fryza97/capacitance_meter/README.md

# capacitance_meter
A laboratory circuit for C measurements based on a direct sensor-to-microcontroller interface circuit and a PIC16F1789 microcontroller.
Engineering thesis from 2020.
