fryza97/capacitance_meter/hardware/fryza-miedź.brd

## EAGLE design hardware/fryza-miedź.brd (2024-04-22)

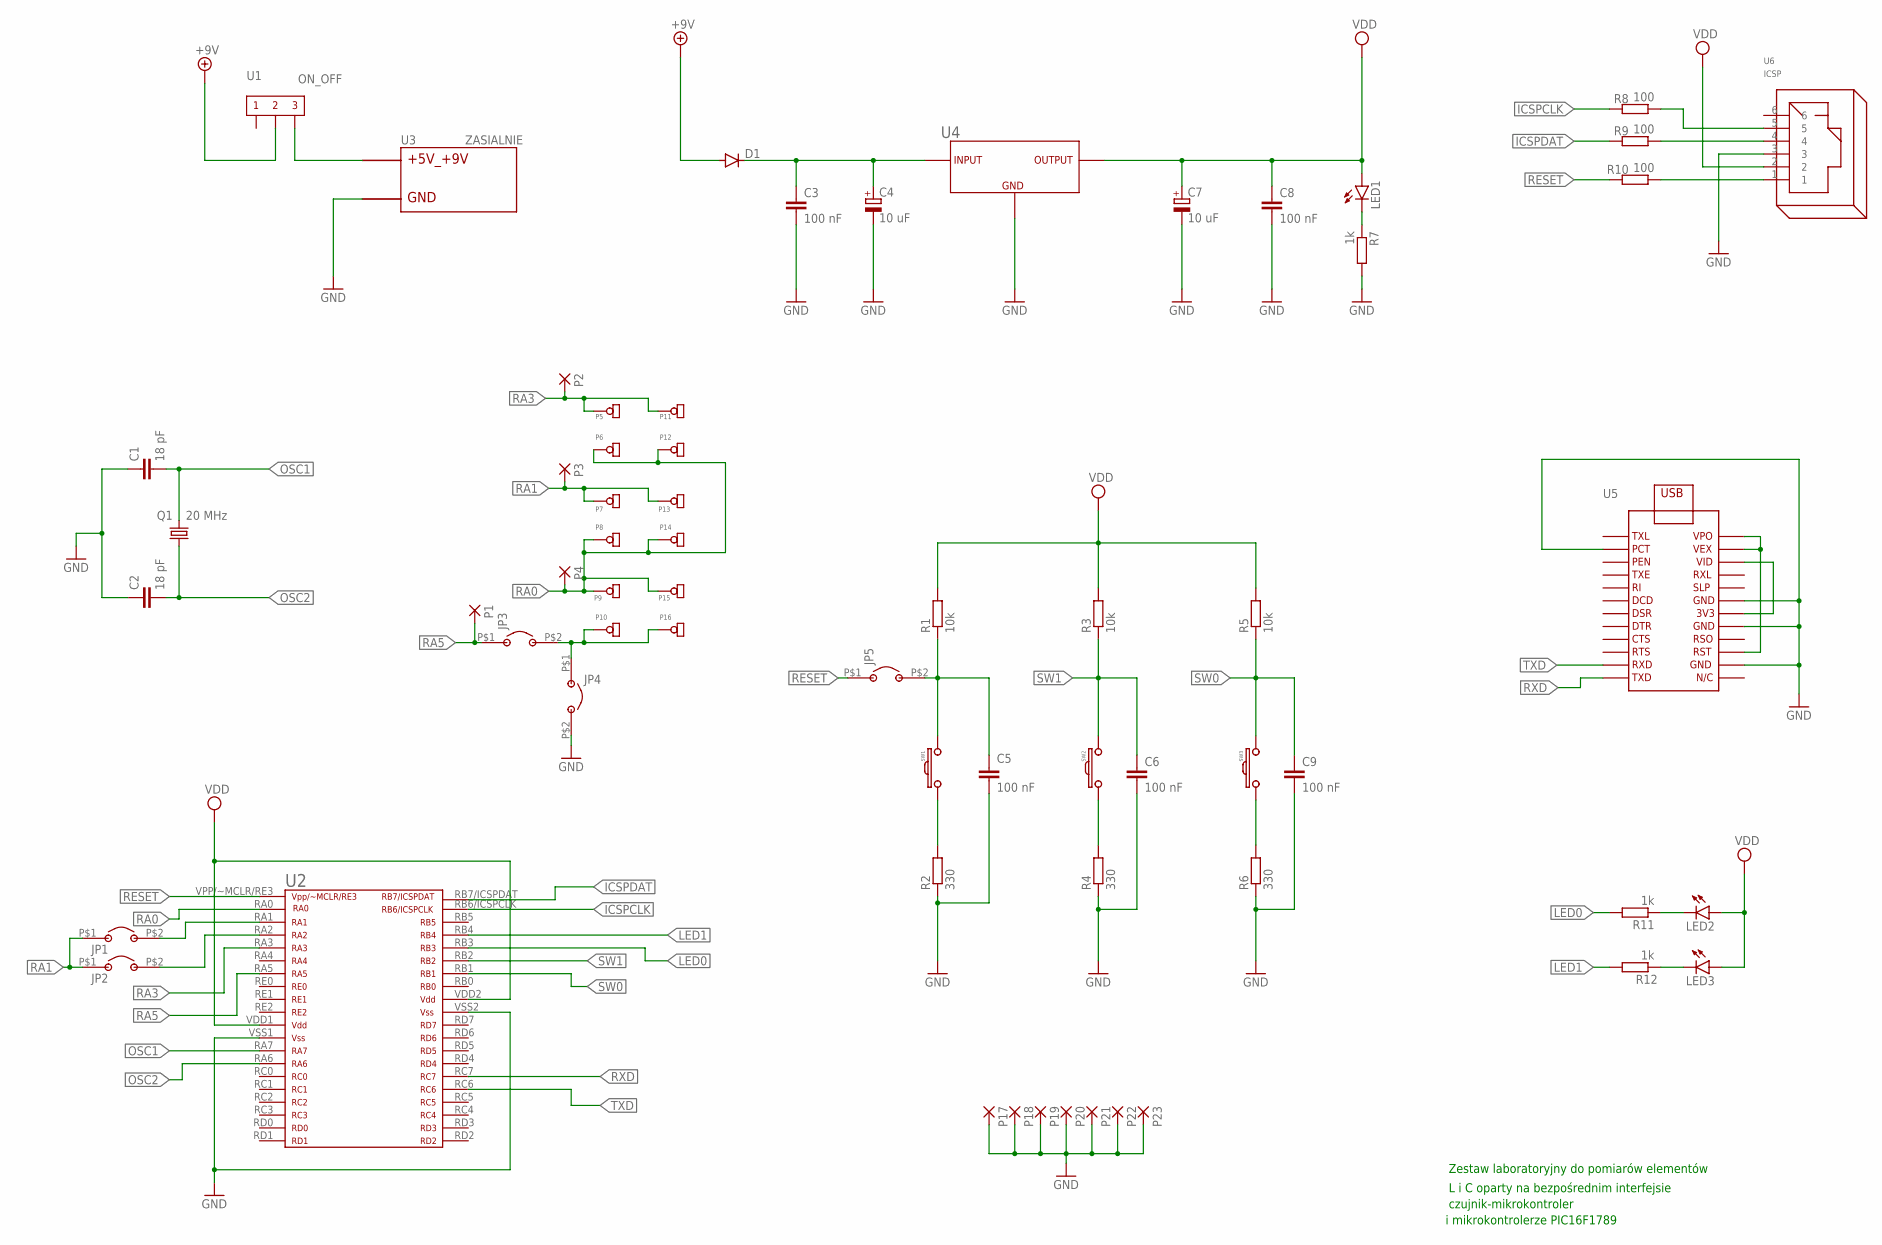
[picture p52: schematic fryza-miedź.sch]

Parts:
C1, C2: 18 pF; C050-035X075
C3, C5, C6, C8, C9: 100 nF; C050-035X075
C4, C7: 10 uF; E2,5-5
D1: 1N4004; DO41-10
JP1, JP2, JP3, JP4, JP5: JUMPER
LED1, LED2, LED3: LED5MM
P1, P2, P3, P4, P17, P18, P19, P20, P21, P22, P23: SZPILKA; CON
P5, P6, P7, P8, P9, P10, P11, P12, P13, P14, P15, P16: CON
Q1: 20 MHz; KWARC
R1, R3, R5: 10k; 0207/10
R2, R4, R6: 330; 0207/10
R7, R11, R12: 1k; 0207/10
R8, R9, R10: 100; 0207/10
SW1, SW2, SW3: PUSH_SWITCH
U1: ON_OFF; WLACZNIK
U2: PIC16F1789
U3: ZASIALNIE; ZASILANIE_ZLACZE
U4: LF33CV
U5: MMUSB232
U6: ICSP; RJ12

Connections:
+9V: D1.A, U1.2
GND: C1.1, C2.1, C3.2, C4.-, C5.2, C6.2, C7.-, C8.2, C9.2, JP4.P$2, P17.P$1, P18.P$1, P19.P$1, P20.P$1, P21.P$1, P22.P$1, P23.P$1, R2.1, R4.1, R6.1, R7.2, U2.VSS1, U2.VSS2, U3.GND1 (GND), U3.GND2 (GND), U4.GND, U5.GND, U5.GND1, U5.GND2, U5.PCT, U6.3
ICSPCLK: R8.2, U2.RB6/ICSPCLK
ICSPDAT: R9.2, U2.RB7/ICSPDAT
LED0: R11.2, U2.RB3
LED1: R12.2, U2.RB4
unnamed: C3.1, C4.+, D1.C, U4.INPUT
unnamed: LED1.K (C), R7.1
unnamed: U1.3, U3.V_S (+5V_+9V)
unnamed: C5.1, JP5.P$2, R1.1, SW1.1_1, SW1.1_2
unnamed: U5.RST, U5.VEX, U5.VPO
unnamed: JP3.P$2, JP4.P$1, P10.P$1, P16.P$1
unnamed: LED2.K (C), R11.1
unnamed: JP1.P$2, U2.RA1
unnamed: LED3.K (C), R12.1
unnamed: R10.1, U6.1
unnamed: R2.2, SW1.2_1, SW1.2_2
unnamed: R6.2, SW3.2_1, SW3.2_2
unnamed: R4.2, SW2.2_1, SW2.2_2
unnamed: U5.3V3, U5.VIO (VID)
unnamed: R8.1, U6.5
unnamed: R9.1, U6.4
OSC1: C1.2, Q1.P$2 (2), U2.RA7
OSC2: C2.2, Q1.P$1 (1), U2.RA6
RA0: P4.P$1, P6.P$1, P8.P$1, P9.P$1, P12.P$1, P14.P$1, P15.P$1, U2.RA0
RA1: JP1.P$1, JP2.P$1, P3.P$1, P7.P$1, P13.P$1
RA2: JP2.P$2, U2.RA2
RA3: P2.P$1, P5.P$1, P11.P$1, U2.RA3
RA5: JP3.P$1, P1.P$1, U2.RA5
RESET: JP5.P$1, R10.2, U2.VPP/~MCLR/RE3
RXD: U2.RC7, U5.TXD
SW0: C9.1, R5.1, SW3.1_1, SW3.1_2, U2.RB1
SW1: C6.1, R3.1, SW2.1_1, SW2.1_2, U2.RB2
TXD: U2.RC6, U5.RXD
VDD: C7.+, C8.1, LED1.A, LED2.A, LED3.A, R1.2, R3.2, R5.2, U2.VDD1, U2.VDD2, U4.OUTPUT, U6.2

Notes on the sheet:
Zestaw laboratoryjny do pomiarów elementów
L i C oparty na bezpośrednim interfejsie
czujnik-mikrokontroler
i mikrokontrolerze PIC16F1789

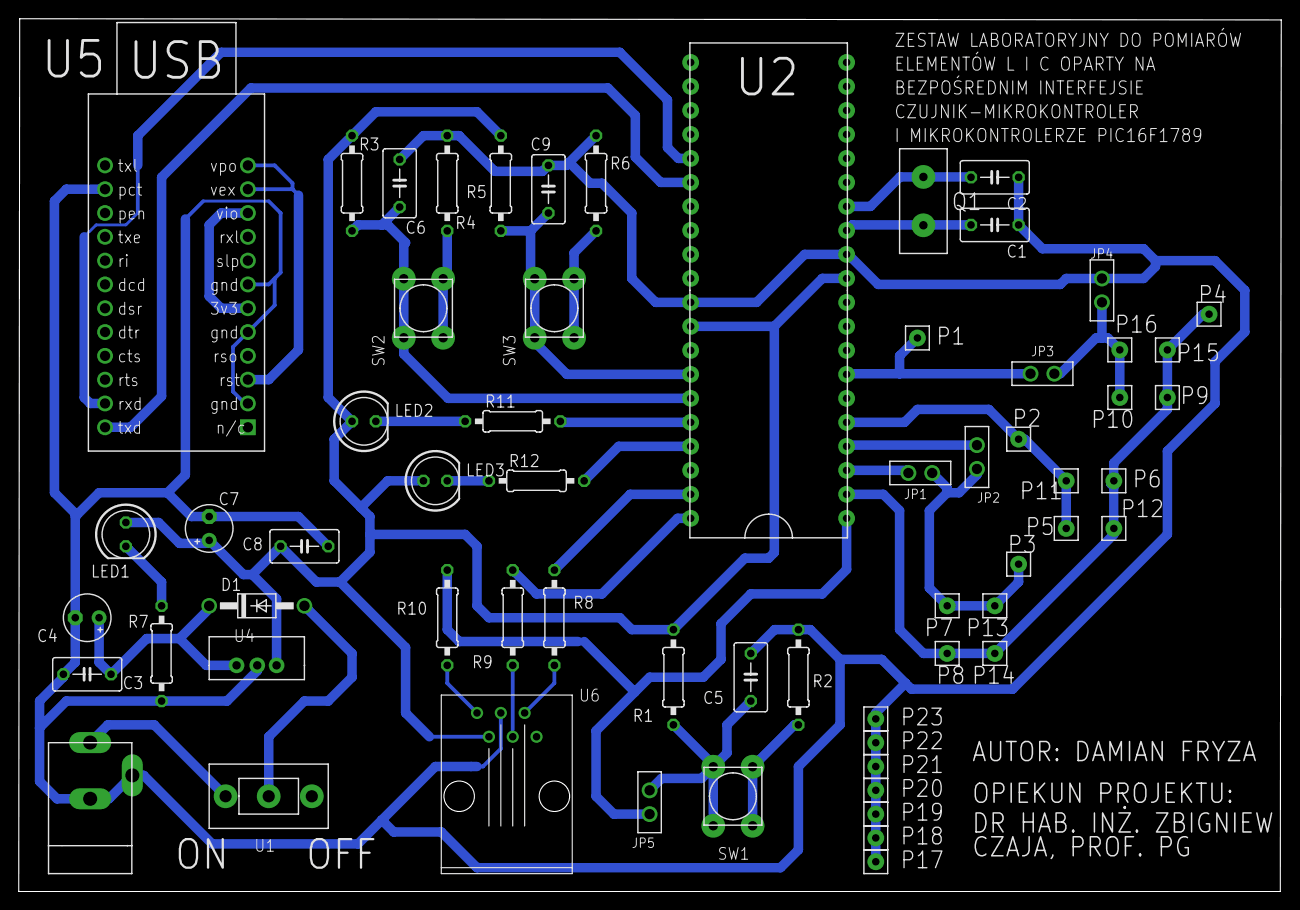
[picture p53: board fryza-miedź.brd from above]

Board: 2 copper layers, 134.7 x 93.1 mm, 63 parts (0 on the bottom side), 35 nets.
